huotui/simHubByArduino/sfx-100/README.md

参考开源sfx-100 
翻译为中国淘宝和材料
材料大概2000元
电机咸鱼二手800元
