huotui/simHubByArduino/sfx-100/丝杠尺寸.jpg

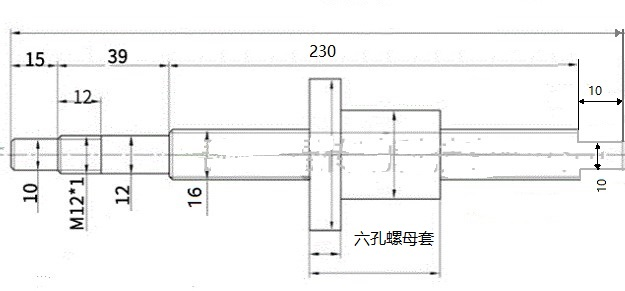
sfx-100/丝杠尺寸.jpg
