huotui/simHubByArduino/sfx-100/g力材料.xlsx

Sheet: Sheet1
类型 | 数量 | 规格 | 淘宝地址 | 原图
铝型材 | 4 | 欧标100100W，长度250mm | 欧标100100W工业铝型材槽10mm壁厚6mm加厚加重铝合金型材大型方管-tmall.com天猫 (https://detail.tmall.com/item.htm?id=606902750048&skuId=4586704530266)
牙套 | 32 | 内M8 外M12 长度15mm（因为原版的型材是10.2孔的，但是中国淘宝的是12孔，故选择m8转m12，开孔12刚刚好） | 不锈钢螺套螺纹转换套变径螺母内外牙实体牙套M12转M8转M6 M6转M4-淘宝网 (taobao.com) (https://item.taobao.com/item.htm?spm=a1z0d.7625083.1998302264.5.5c5f4e69CNv0JQ&id=597279255542)
欧标型材T型螺母 | 16 | 欧标型材T型螺母 m8 | 欧标型材T型螺母t型滑块方形20型30型40型45型-M3-M4-M5-M6-M8-M-淘宝网 (taobao.com) (https://item.taobao.com/item.htm?spm=a1z0d.7625083.1998302264.6.5c5f4e69TDohLu&id=41966325030) | 标准
空心轴 | 4 | 外径30 内径18 长度300 | 空心光轴镀铬空心轴空心杆硬轴软轴16 20 25 30 32 35 38 40-100-淘宝网 (taobao.com) (https://item.taobao.com/item.htm?spm=a1z0d.7625083.1998302264.6.5c5f4e69E7prWv&id=45696131246) | 内径大于滚珠丝杠外径
滚珠丝杠 | 4 | 1605-3 长度250mm | 滚珠丝杆副 丝杠螺母套装SFU1204 1605 2004 2005 3210 4010 滑台-淘宝网 (taobao.com) (https://item.taobao.com/item.htm?spm=a1z0d.7625083.1998302264.6.5c5f4e699CKdqX&id=612557618114)
固定轴承 | 4 | FK12 | 滚珠丝杆支撑座EK/EF10 12 15 20 2530BF/BK/FK/FF丝杠轴承固定座-淘宝网 (taobao.com) (https://item.taobao.com/item.htm?spm=a1z0d.7625083.1998302264.6.5c5f4e69TIiftM&id=39444356273)
欧标直线方法兰轴承 | 4 | LMEK30UU | 欧标直线方法兰轴承LMEK12 16 20 25 30 40 50UU滑动衬套电镀防锈-淘宝网 (taobao.com) (https://item.taobao.com/item.htm?spm=a1z0d.7625083.1998302264.5.5c5f4e69SGisXd&id=608403005576) | 标准
梅花联轴器 | 4 | 梅花联轴器 外径30mm，长度40mm，内径10mm，内径16mm | 梅花联轴器星型丝杆编码器弹性大扭矩连轴器伺服电机铝合金联轴器-淘宝网 (taobao.com) (https://item.taobao.com/item.htm?spm=a230r.1.14.8.24592502RmrGGR&id=562153881737&ns=1&abbucket=9) | 标准
D接头母25 | 4
Arduino Leonardo | 1
伺服电机 | 4 | 90ST-M02430 220V 750W
o型橡胶环 | 4 | 23,5 x 30,5 x 3,5mm
面包板 | 1
电机紧急按钮 | 1
pla打印机材料
橡胶垫 |  | 4,5 x 2 cm
螺丝DIN 912 | 32 | M8 x 40
螺丝DIN 912 | 16 | M6 x 85
螺丝DIN 912 | 16 | M6 x 25
螺丝DIN 912 | 16 | M4 x 25
螺丝DIN 6912 | 24 | M5 x 20
垫片DIN 125 | 32 | A8,4 （外径16，内径8.4，厚1.6
 | 32 | A6,4 （外径12，内径6.4，厚1.6）

Sheet: Sheet2
SIMANALOG模似赛车座椅模拟器
【支架基础方案】 |  |  |  |  |  | 【专用配件】
淘宝店-链接点击 (https://mbyuan.tmall.com) | 位置 | 尺寸mm | 数量 | 单价 | 金额 | 链接-下点击 | 型号 | 个数 | 单价 | 金额
银色-欧标40120 | 方向盘 | 540 | 1 |  |  | 角件 (https://item.taobao.com/item.htm?spm=a1z10.1-c.w4004-15456209021.44.7e94307aQKsIYo&id=525590555913) | 4040 | 100
银色-欧标4080W | 底部 | 1200 | 2 |  |  | 方型螺母 (https://item.taobao.com/item.htm?_u=l2uiltb26874&id=36238875992) | M8 | 260
 | 立柱 | 1000 | 2 |  |  | 六角螺丝 (https://item.taobao.com/item.htm?spm=a1z10.3-c.w4002-13239324996.12.701f6e1cy5GZSi&id=43228853853) | M8*50 | 20
 | 底部 | 540 | 2 |  |  |  | M8*40 | 20
 | 座椅 | 350 | 2 |  |  |  | M8*35 | 20
 | 方向盘 | 250 | 2 |  |  |  | M8*16 | 230
银色-欧标4040W | 单屏32-40寸 | 620 | 1 |  |  |  | M8*12 | 30
 | 踏板 底部 | 540 | 4 |  |  |  | M6*50 | 20
 | 踏板 | 310 | 2 |  |  |  | M4*40 | 20
 | 踏板 | 280 | 2 |  |  | 垫片 (https://item.taobao.com/item.htm?spm=a1z10.3-c.w4002-13239324996.13.26a96e1cZTLgEK&id=541340013462) | M8 | 260
 | 排挡 | 840 | 1 |  |  | 六角扳手 (https://item.taobao.com/item.htm?spm=a1z0d.6639537.1997196601.36.79677484sMZZKU&id=575413490538) | 6mm | 2
 | 排挡 | 150 | 4 |  |  | https://item.taobao.com/item.htm?spm=a1z0d.6639537.1997196601.36.79677484sMZZKU&id=575413490538 | 5mm | 2
 | 排挡 | 250 | 1 |  |  | https://item.taobao.com/item.htm?spm=a1z0d.6639537.1997196601.36.79677484sMZZKU&id=575413490538 | 4mm | 2
 |  |  |  |  |  | 端盖欧标 (https://item.taobao.com/item.htm?spm=a1z10.3-c.w4002-13239324996.9.11966e1cx2CkkH&id=529659180247) | 4040 | 10
运费-广东 |  |  |  |  |  | https://item.taobao.com/item.htm?spm=a1z10.3-c.w4002-13239324996.9.11966e1cx2CkkH&id=529659180247 | 4080 | 20
合计 |  |  |  |  | 805.00 | 活动铰链 (https://item.taobao.com/item.htm?spm=a1z0d.6639537.1997196601.67.79677484sMZZKU&id=520485589728) | 4040 | 4
备注 | 含5%切割损耗，铝型膜不要撕，用珍珠棉包装好防止摔破。 |  |  |  |  | 垫脚 (https://detail.tmall.com/item.htm?_u=62uiltb274cc&id=592220353108) | 36*28*25 | 10
 |  |  |  |  | 35KG/公斤 | 合计 |  |  |  | 318.00
 |  |  |  |  |  |  |  |  |  | 11KG/公斤
