huotui/simHubByArduino/break/break.ino

#include <Joystick.h>

// Create the Joystick

Joystick_ Joystick(JOYSTICK_DEFAULT_REPORT_ID, 
  JOYSTICK_TYPE_JOYSTICK, 0, 0,
  false, false, false, true, true, false,
  false, false, false, false, false);

void setup() {
  // Initialize Joystick Library
  Joystick.setRxAxisRange(0, 1023);
  Joystick.setRyAxisRange(0, 1023);
  Joystick.begin(false);
}

void loop() {
  int16_t val = analogRead(0);
  //Serial.println(val);
  Joystick.setRxAxis(val);


   int16_t val3 = analogRead(3);
  //Serial.println(val);
  Joystick.setRyAxis(val3);
  Joystick.sendState();
  delay(10);
}
